markday275/SOLAR-CAR/SCHEMATIC.pdf

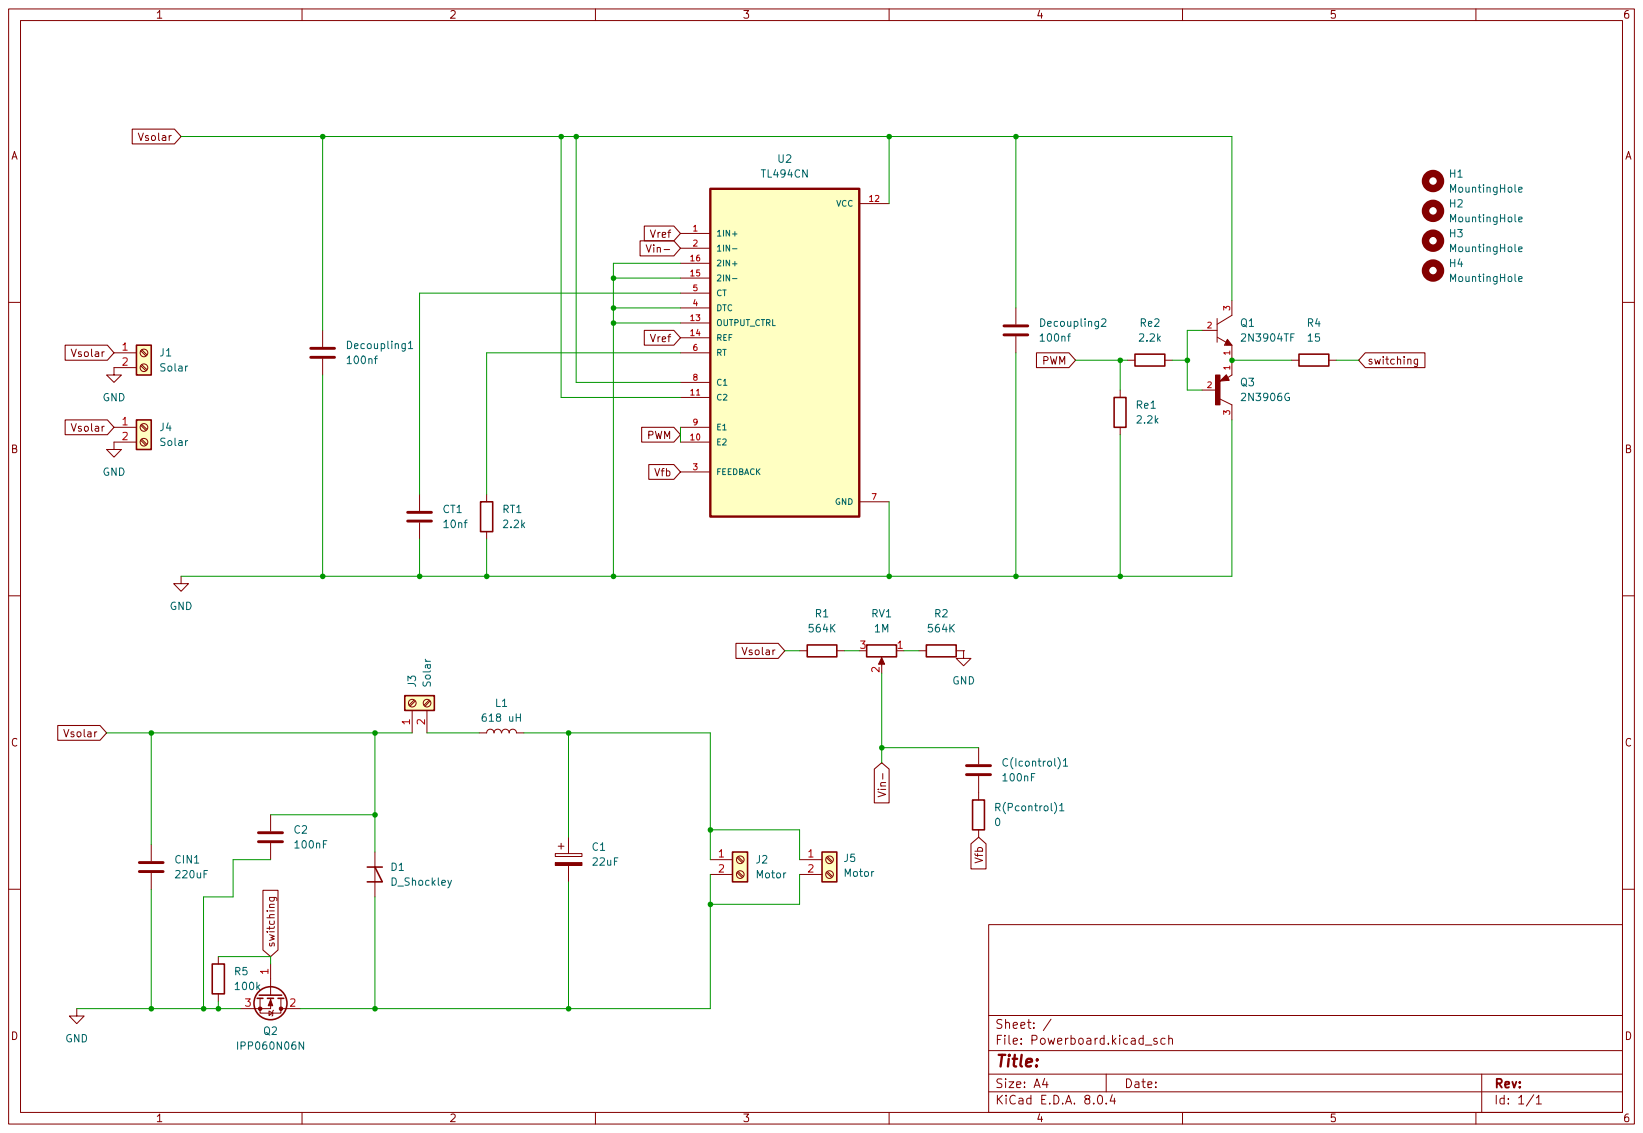
[picture p15: page 1]
